min-lfl/Red_Switch/(list of files, cad)

Other CAD files:
Code/Objects/main.obj
Code/Objects/delay.obj
Code/Objects/Servo.obj
Code/Objects/EEROM.obj
Code/Objects/RedWAI.obj
Code/Objects/vcc.obj
Code/Objects/uart.obj
Code/Objects/lcd1602.obj
Code/Objects/Switch0000.obj
Code/Objects/Timer0.obj
Code/Objects/SERVO_DRIVER.obj
