min-lfl/Red_Switch/(list of files, drawings)

Other design files:
Proteus/Project Backups/Red_Switch [20260407, 16-53-16].pdsprj
Proteus/Project Backups/Red_Switch [20260407, 19-05-22].pdsprj
Proteus/Red_Switch.pdsprj
