min-lfl/Red_Switch/(commit log)

2025-12-11 初代版本，完成基本功能，红外接收控制舵机小幅摆动完成开关作用
    [RedWAI.obj, SERVO_DRIVER.obj, Servo.obj, Switch0000.obj, Timer0.obj, delay.obj, lcd1602.obj, main.obj]
2025-12-11 优化了部分关于舵机控制的代码，减小了部分不必要的寄存器写操作
    [RedWAI.obj, Servo.obj, Switch0000.obj, Timer0.obj, delay.obj, lcd1602.obj, main.obj]
2026-04-07 移植keil5环境,吧51单片机换成了stc15w408as单片机,编译通过
    [RedWAI.obj, Red_Switch.pdsprj, SERVO_DRIVER.obj, Servo.obj, Switch0000.obj, Timer0.obj, delay.obj, lcd1602.obj]
2026-04-07 增加串口读取写入函数,完成烧录测试,完善部分原理图
    [RedWAI.obj, Red_Switch [20260407, 16-53-16].pdsprj, Red_Switch.pdsprj, Servo.obj, Switch0000.obj, Timer0.obj, delay.obj, lcd1602.obj]
2026-04-07 在嘉立创EDA专业版完成原理图和PCB图的绘制,准备检查后打板
    [Red_Switch [20260407, 16-53-16].pdsprj, Red_Switch [20260407, 19-05-22].pdsprj, Red_Switch.pdsprj]
2026-04-09 准备开始调试红外解码模块,现在保存回退点
    [RedWAI.obj, Servo.obj, Switch0000.obj, Timer0.obj, delay.obj, lcd1602.obj, main.obj, uart.obj]
2026-04-09 问题原因已经找到,stc15w408as没有定时器1和定时器4,只有定时器0和定时器2
    定时器2会被串口占用,所有只能使用定时器0
    [RedWAI.obj, Servo.obj, Switch0000.obj, Timer0.obj, delay.obj, lcd1602.obj, main.obj, uart.obj]
2026-04-09 准备开始大刀阔斧的改造红外模块
    [RedWAI.obj, Servo.obj, Switch0000.obj, Timer0.obj, delay.obj, lcd1602.obj, main.obj, uart.obj]
2026-04-10 完成了PCB板的绘制以及制版文件的导出,第三版,接近完美了
    [RedWAI.obj, Servo.obj, Switch0000.obj, Timer0.obj, delay.obj, lcd1602.obj, main.obj, uart.obj]
2026-04-15 完成了红外接收的修复,神功大成,原因是定时器错误的使用了1T模式,导致计数大了12倍,起始位更是直接溢出
    [RedWAI.obj, Servo.obj, Switch0000.obj, Timer0.obj, delay.obj, lcd1602.obj, main.obj, uart.obj]
2026-04-15 有大量调试痕迹的代码
    [RedWAI.obj, Servo.obj, Switch0000.obj, Timer0.obj, delay.obj, lcd1602.obj, main.obj, uart.obj]
2026-04-15 完善了红外接收的代码注释
    [RedWAI.obj, Servo.obj, Switch0000.obj, Timer0.obj, delay.obj, lcd1602.obj, main.obj, uart.obj]
2026-04-16 增加了大量关于红外接收驱动的注释,提高了可移植性
    [RedWAI.obj, Servo.obj, Switch0000.obj, Timer0.obj, delay.obj, lcd1602.obj, main.obj, uart.obj]
2026-04-17 完成了PCA模块,可以稳定输出PWM波控制舵机了
    [RedWAI.obj, Servo.obj, Switch0000.obj, Timer0.obj, delay.obj, lcd1602.obj, main.obj, uart.obj]
2026-04-26 画完了第三版的PCB图,增加了电池电压监控功能,改进了部分电路
    增加了电路防防反接功能,并且从NMOS管改用PMOS管,彻底解决了单片机概率开机失败的问题,改变了部分电路电容/电阻的值,使得输出波形更加稳定,并且在按钮两端增加了硬件级滤波
    [关于舵机数据处理.xlsx]
2026-04-26 熬夜干完了第四版PCB,在原来的基础上增加了typec充电电路,并且优化了部分布局
    因为系统功能增加了,后面准备出一本产品使用说明书
2026-04-27 编写了部分项目文档MD,完善了项目介绍
    本使用说明介绍了一款基于STC15微控制器和SG90服务器的低功耗红外遥控智能开关。它详细阐述了项目特性硬件架构、软件设计、性能指标以及使用说明。
2026-04-27 文档第一版
2026-04-27 添加了更多的图表介绍此项目
2026-05-06 微调电路板
2026-05-07 大版本更新,直接写完了所有业务代码,控制逻辑,更改键值,低电压检测,自动休眠省电
    [EEROM.obj, RedWAI.obj, Servo.obj, delay.obj, main.obj, uart.obj, vcc.obj]
2026-05-07 增加了部分图片,更加全面介绍项目
    增加了部分图片
2026-05-07 再次优化的低功耗设计,把所有悬空引脚都设置推挽模式并且拉低,防止了所有可能的漏电流
    [EEROM.obj, RedWAI.obj, Servo.obj, delay.obj, main.obj, uart.obj, vcc.obj]
2026-05-07 整理了一部分的文件,使模块结构更加清晰
    [EEROM.obj, RedWAI.obj, Servo.obj, delay.obj, main.obj, uart.obj, vcc.obj, 关于舵机数据处理.xlsx]
2026-05-22 通过软件算法规避了可能会导致关灯失败的问题,增加了力矩跟随电压变化,电压越小电机输出相对力矩越大
    [EEROM.obj, RedWAI.obj, Servo.obj, delay.obj, main.obj, uart.obj, vcc.obj]
2026-10-01 更新部分md说明文档
